Alexdelia/keyboard/keyboard/icarus/pcb/right/right.kicad_pcb

## KiCad design keyboard/icarus/pcb/right/right.kicad_pcb (2026-11-09)

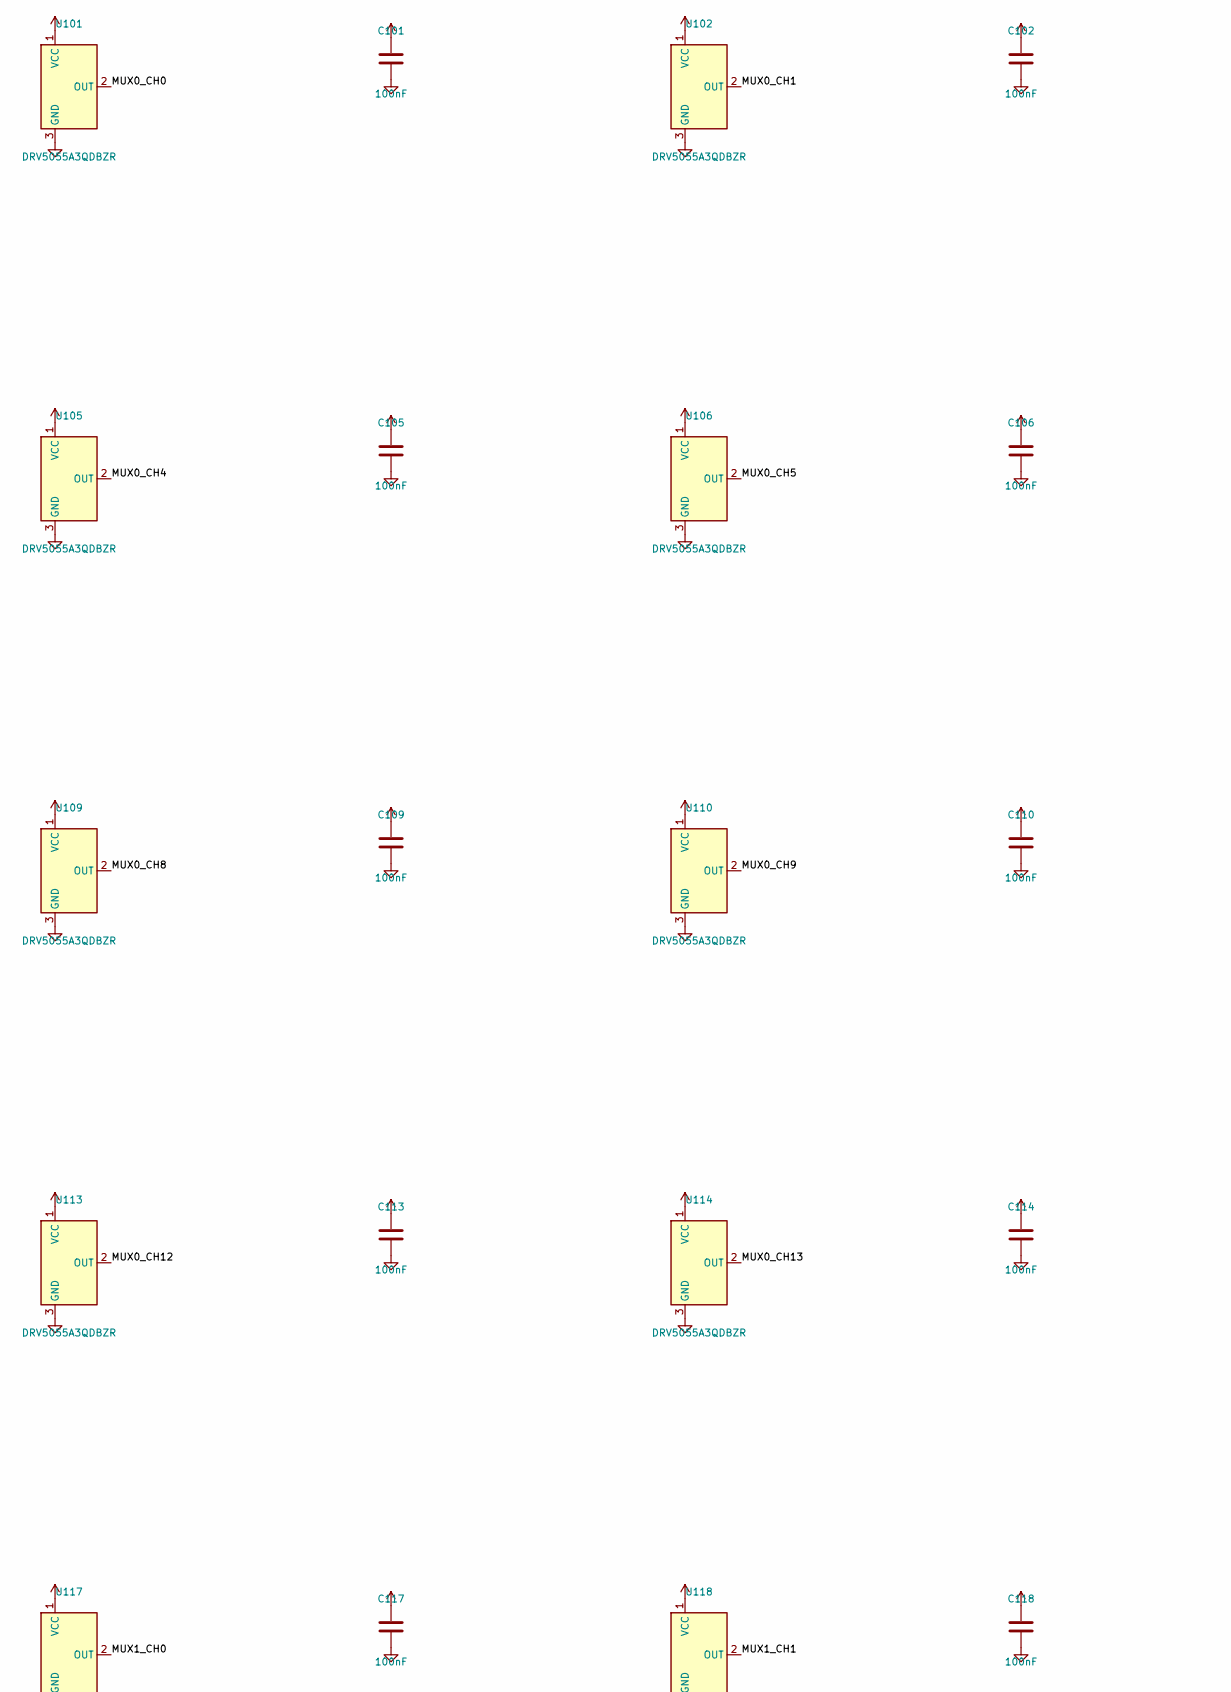
[picture p1: schematic right.kicad_sch, part in row 1, column 1]

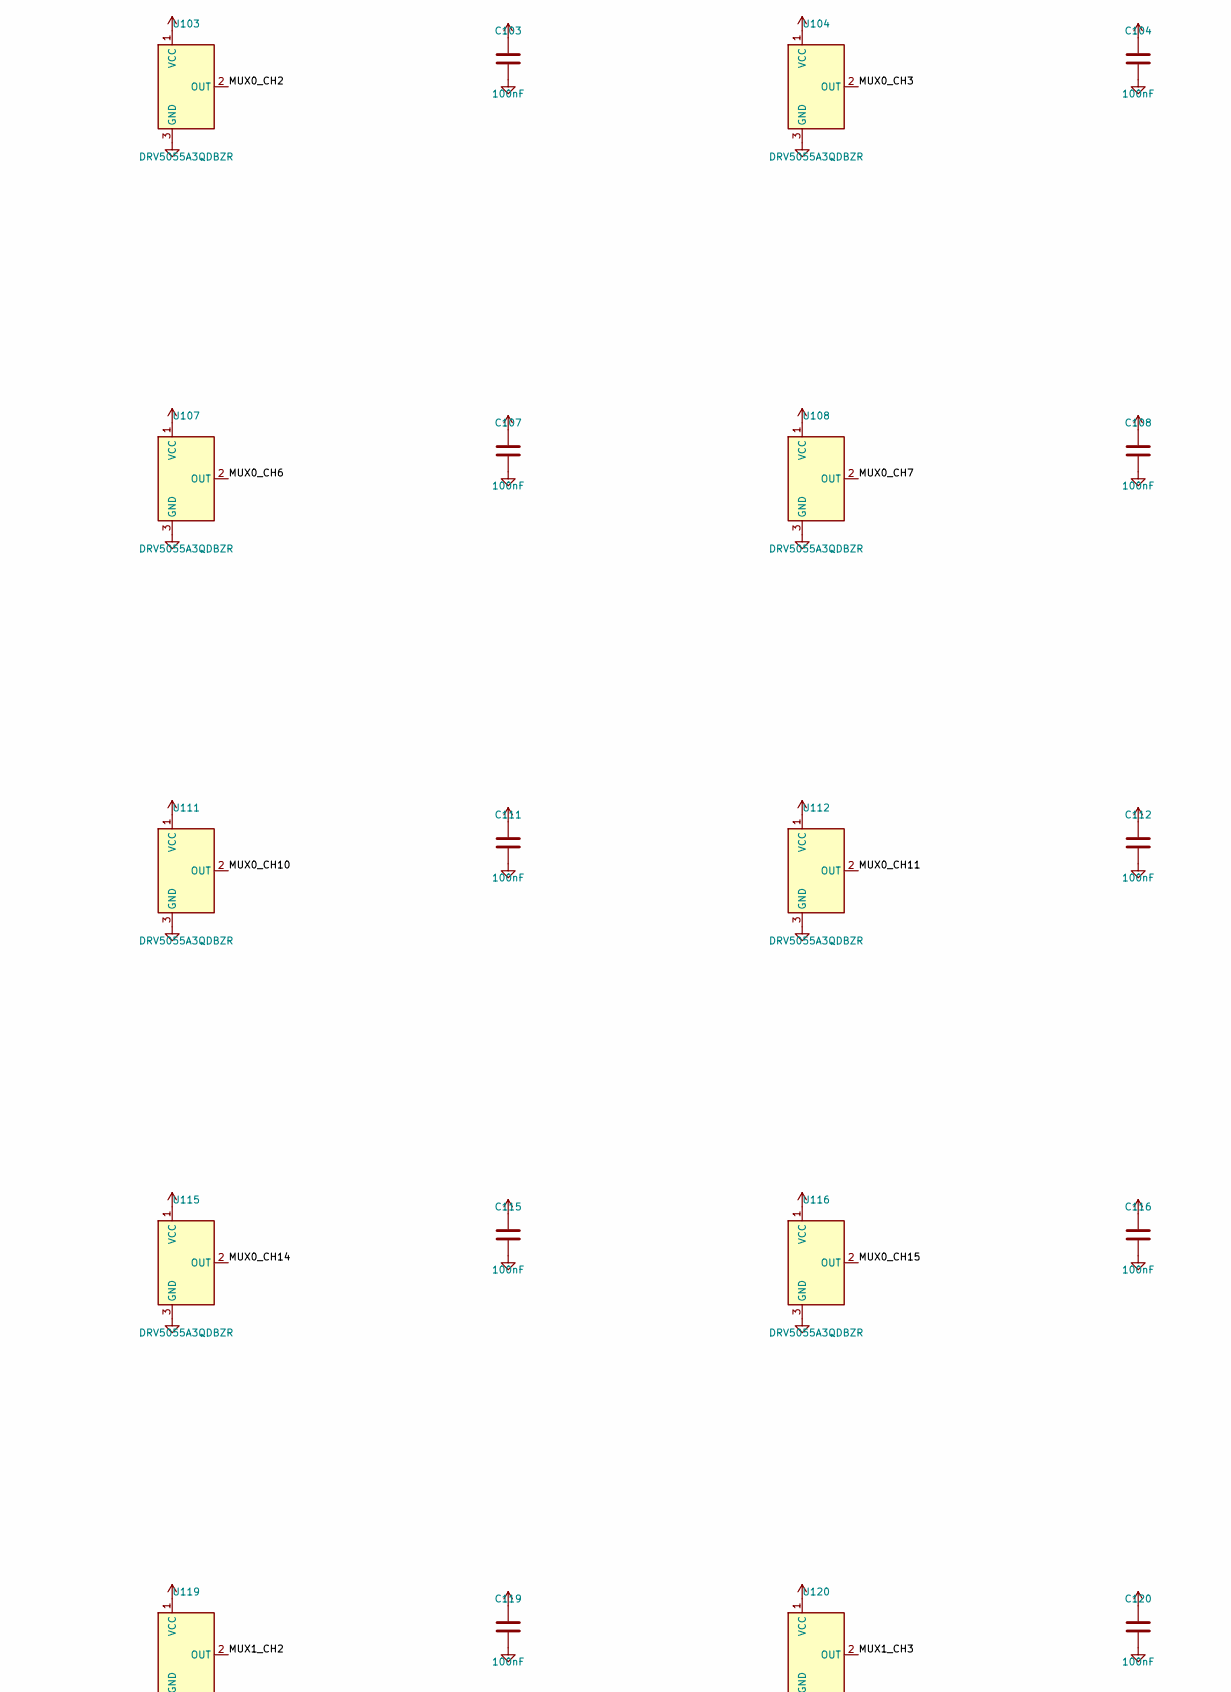
[picture p2: schematic right.kicad_sch, part in row 1, column 2]

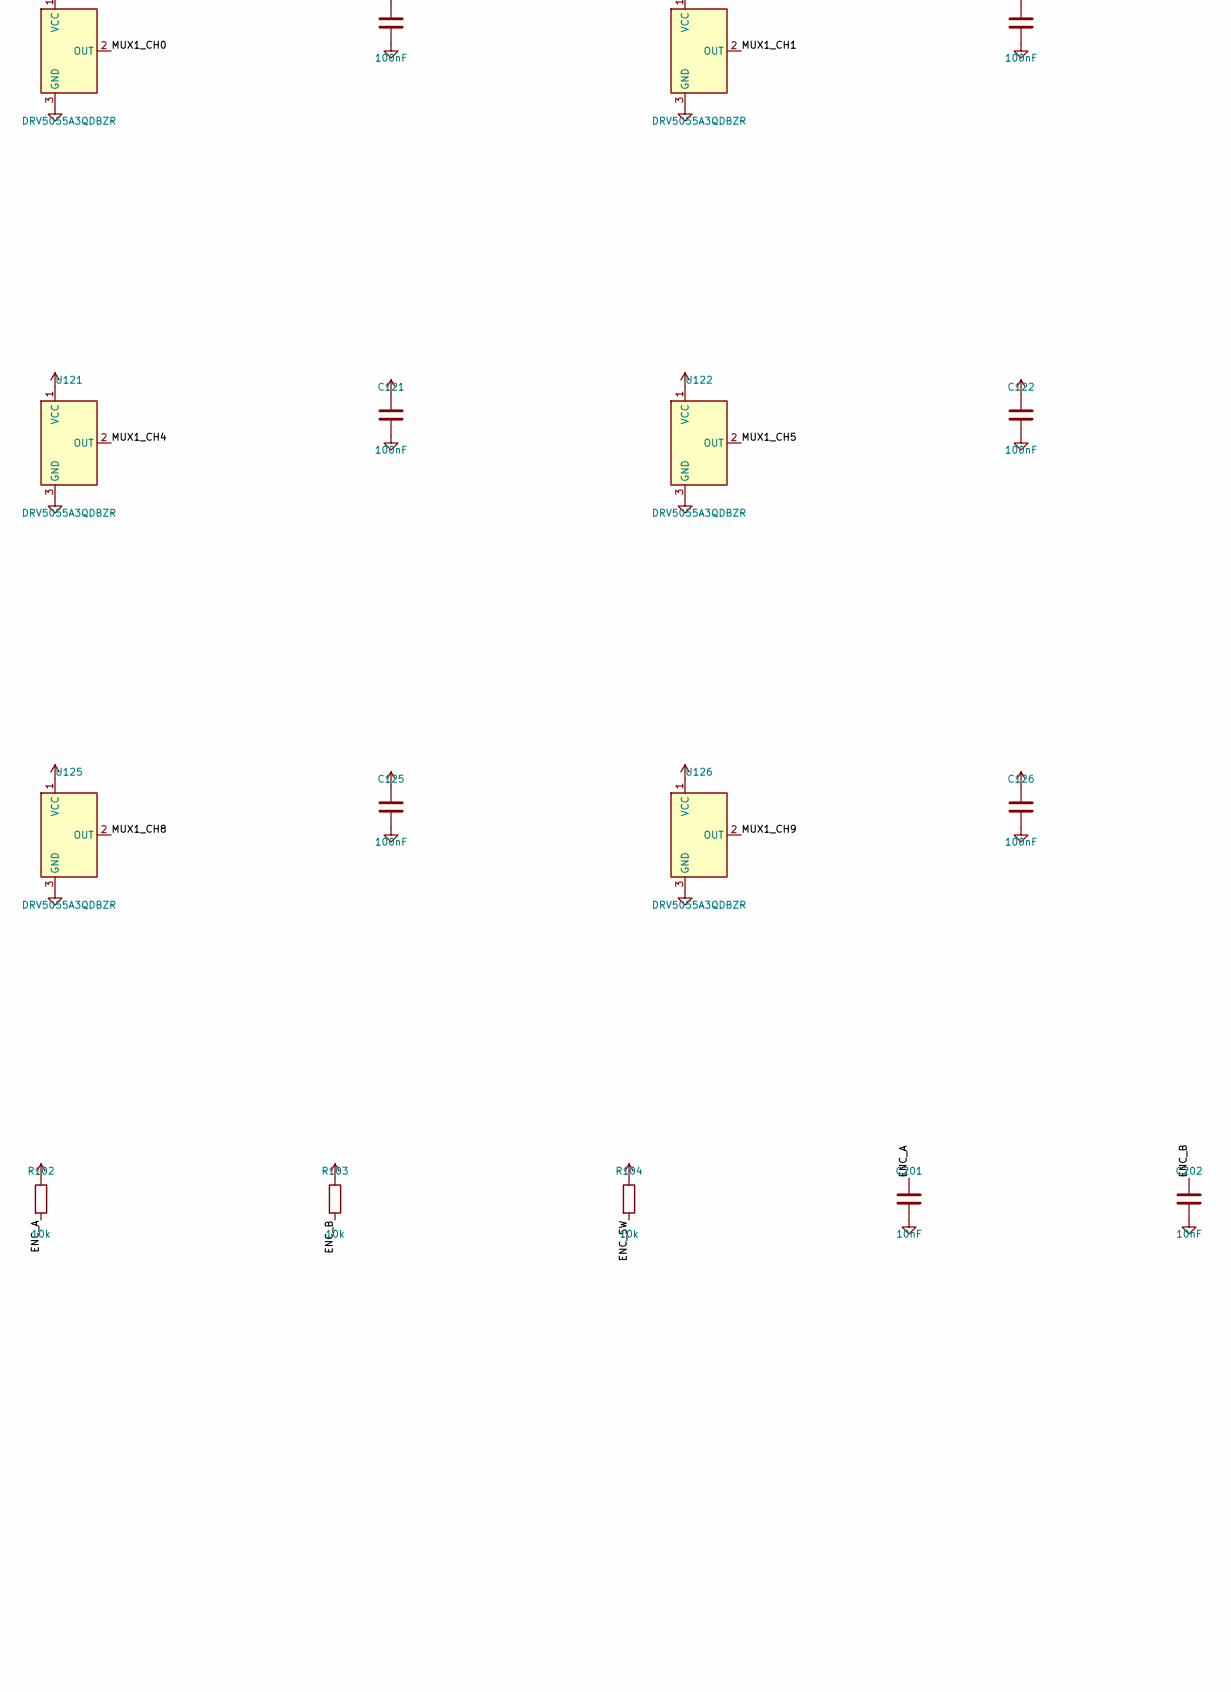
[picture p3: schematic right.kicad_sch, part in row 2, column 1]

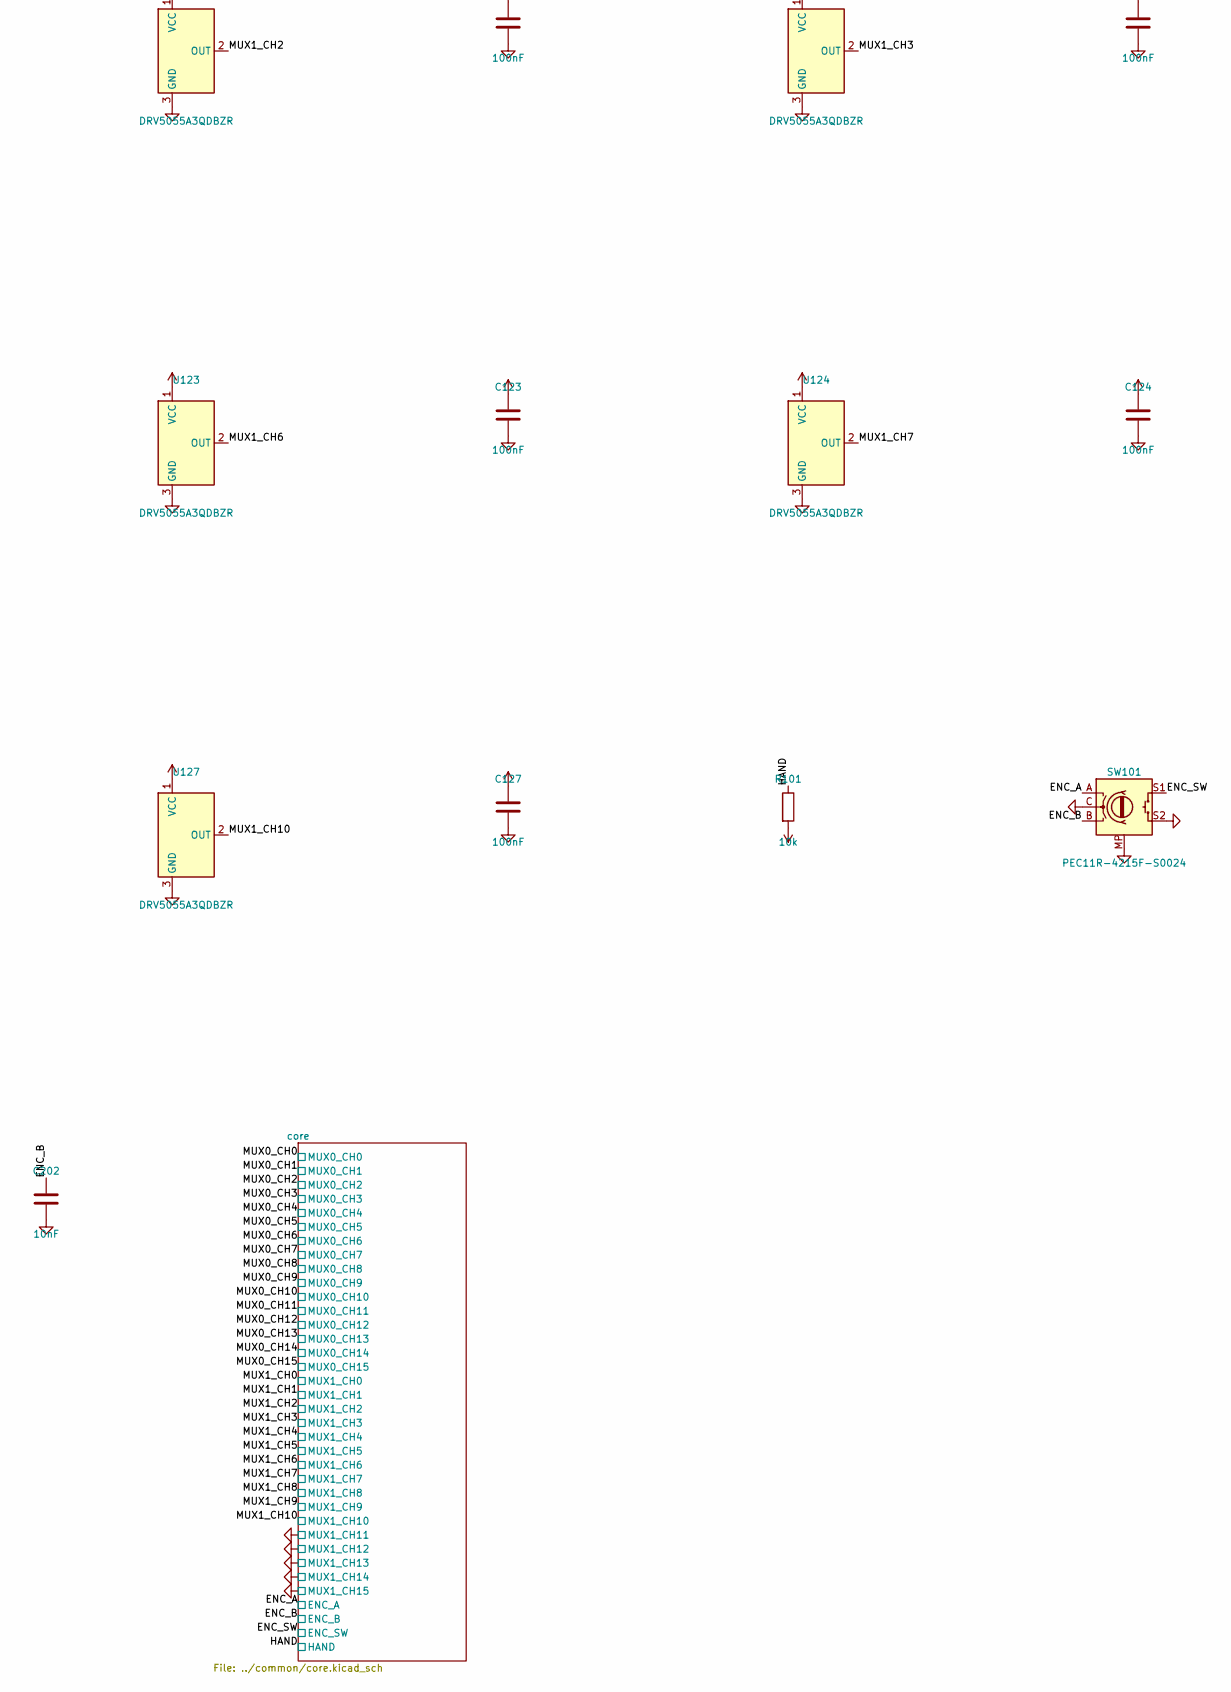
[picture p4: schematic right.kicad_sch, part in row 2, column 2]

Parts:
C101, C102, C103, C104, C105, C106, C107, C108, C109, C110, C111, C112, C113, C114, C115, C116, C117, C118, C119, C120, C121, C122, C123, C124, C125, C126, C127: 100nF; C_0402_1005Metric; MPN CL05B104KO5NNNC; LCSC C1525
C201, C202: 10nF; C_0402_1005Metric; MPN CL05B103KB5NNNC; LCSC C15195
R101, R102, R103, R104: 10k; R_0402_1005Metric; MPN 0402WGF1002TCE; LCSC C25744
SW101: PEC11R-4215F-S0024; RotaryEncoder_Bourns_PEC11R-4xxxF-Sxxxx_Vertical; MPN PEC11R-4215F-S0024; LCSC C143790
U101, U102, U103, U104, U105, U106, U107, U108, U109, U110, U111, U112, U113, U114, U115, U116, U117, U118, U119, U120, U121, U122, U123, U124, U125, U126, U127: DRV5055A3QDBZR; SOT-23; MPN DRV5055A3QDBZR; LCSC C266128

Connections:
+3V3: C101.1, C102.1, C103.1, C104.1, C105.1, C106.1, C107.1, C108.1, C109.1, C110.1, C111.1, C112.1, C113.1, C114.1, C115.1, C116.1, C117.1, C118.1, C119.1, C120.1, C121.1, C122.1, C123.1, C124.1, C125.1, C126.1, C127.1, R101.2, R102.1, R103.1, R104.1, U101.1 (VCC), U102.1 (VCC), U103.1 (VCC), U104.1 (VCC), U105.1 (VCC), U106.1 (VCC), U107.1 (VCC), U108.1 (VCC), U109.1 (VCC), U110.1 (VCC), U111.1 (VCC), U112.1 (VCC), U113.1 (VCC), U114.1 (VCC), U115.1 (VCC), U116.1 (VCC), U117.1 (VCC), U118.1 (VCC), U119.1 (VCC), U120.1 (VCC), U121.1 (VCC), U122.1 (VCC), U123.1 (VCC), U124.1 (VCC), U125.1 (VCC), U126.1 (VCC), U127.1 (VCC); also elsewhere on the board
/ENC_A: C201.1, R102.2, SW101.A; also elsewhere on the board
/ENC_B: C202.1, R103.2, SW101.B; also elsewhere on the board
/ENC_SW: R104.2, SW101.S1; also elsewhere on the board
/HAND: R101.1; also elsewhere on the board
/MUX0_CH0: U101.2 (OUT); also elsewhere on the board
/MUX0_CH1: U102.2 (OUT); also elsewhere on the board
/MUX0_CH2: U103.2 (OUT); also elsewhere on the board
/MUX0_CH3: U104.2 (OUT); also elsewhere on the board
/MUX0_CH4: U105.2 (OUT); also elsewhere on the board
/MUX0_CH5: U106.2 (OUT); also elsewhere on the board
/MUX0_CH6: U107.2 (OUT); also elsewhere on the board
/MUX0_CH7: U108.2 (OUT); also elsewhere on the board
/MUX0_CH8: U109.2 (OUT); also elsewhere on the board
/MUX0_CH9: U110.2 (OUT); also elsewhere on the board
/MUX0_CH10: U111.2 (OUT); also elsewhere on the board
/MUX0_CH11: U112.2 (OUT); also elsewhere on the board
/MUX0_CH12: U113.2 (OUT); also elsewhere on the board
/MUX0_CH13: U114.2 (OUT); also elsewhere on the board
/MUX0_CH14: U115.2 (OUT); also elsewhere on the board
/MUX0_CH15: U116.2 (OUT); also elsewhere on the board
/MUX1_CH0: U117.2 (OUT); also elsewhere on the board
/MUX1_CH1: U118.2 (OUT); also elsewhere on the board
/MUX1_CH2: U119.2 (OUT); also elsewhere on the board
/MUX1_CH3: U120.2 (OUT); also elsewhere on the board
/MUX1_CH4: U121.2 (OUT); also elsewhere on the board
/MUX1_CH5: U122.2 (OUT); also elsewhere on the board
/MUX1_CH6: U123.2 (OUT); also elsewhere on the board
/MUX1_CH7: U124.2 (OUT); also elsewhere on the board
/MUX1_CH8: U125.2 (OUT); also elsewhere on the board
/MUX1_CH9: U126.2 (OUT); also elsewhere on the board
/MUX1_CH10: U127.2 (OUT); also elsewhere on the board
GND: C101.2, C102.2, C103.2, C104.2, C105.2, C106.2, C107.2, C108.2, C109.2, C110.2, C111.2, C112.2, C113.2, C114.2, C115.2, C116.2, C117.2, C118.2, C119.2, C120.2, C121.2, C122.2, C123.2, C124.2, C125.2, C126.2, C127.2, C201.2, C202.2, SW101.C, SW101.MP, SW101.S2, U101.3 (GND), U102.3 (GND), U103.3 (GND), U104.3 (GND), U105.3 (GND), U106.3 (GND), U107.3 (GND), U108.3 (GND), U109.3 (GND), U110.3 (GND), U111.3 (GND), U112.3 (GND), U113.3 (GND), U114.3 (GND), U115.3 (GND), U116.3 (GND), U117.3 (GND), U118.3 (GND), U119.3 (GND), U120.3 (GND), U121.3 (GND), U122.3 (GND), U123.3 (GND), U124.3 (GND), U125.3 (GND), U126.3 (GND), U127.3 (GND); also elsewhere on the board

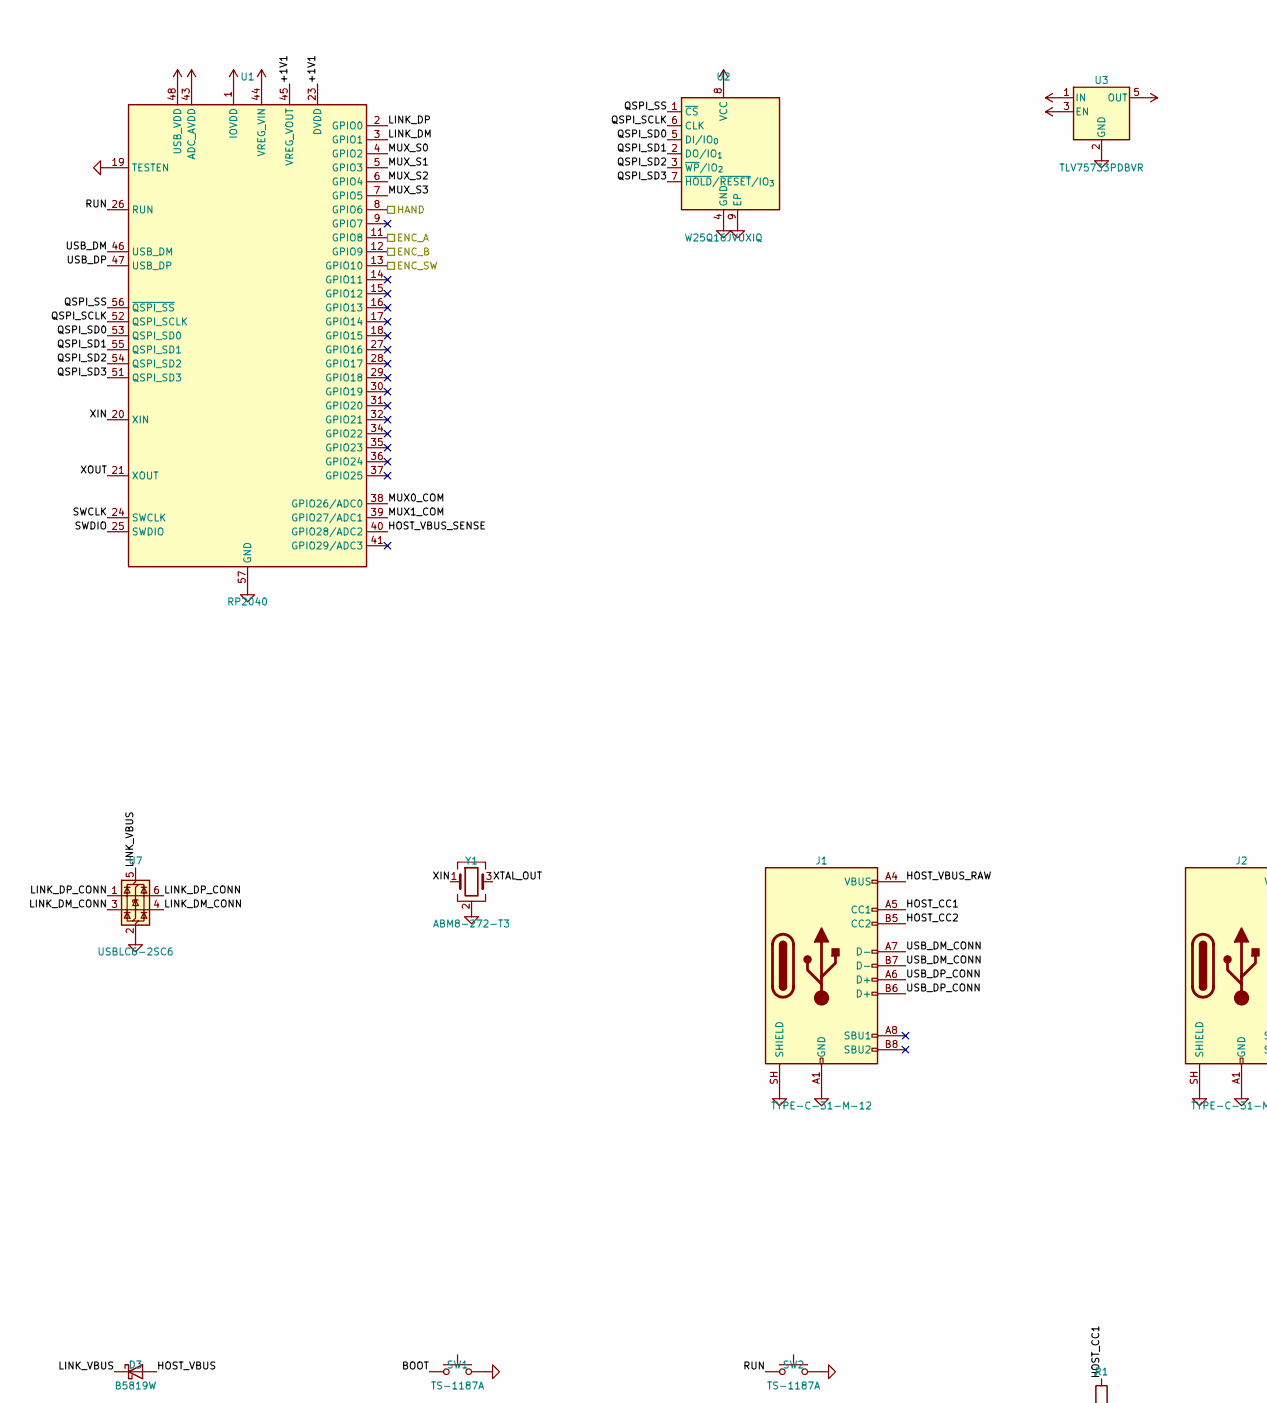
[picture p5: schematic core.kicad_sch, part in row 1, column 1]

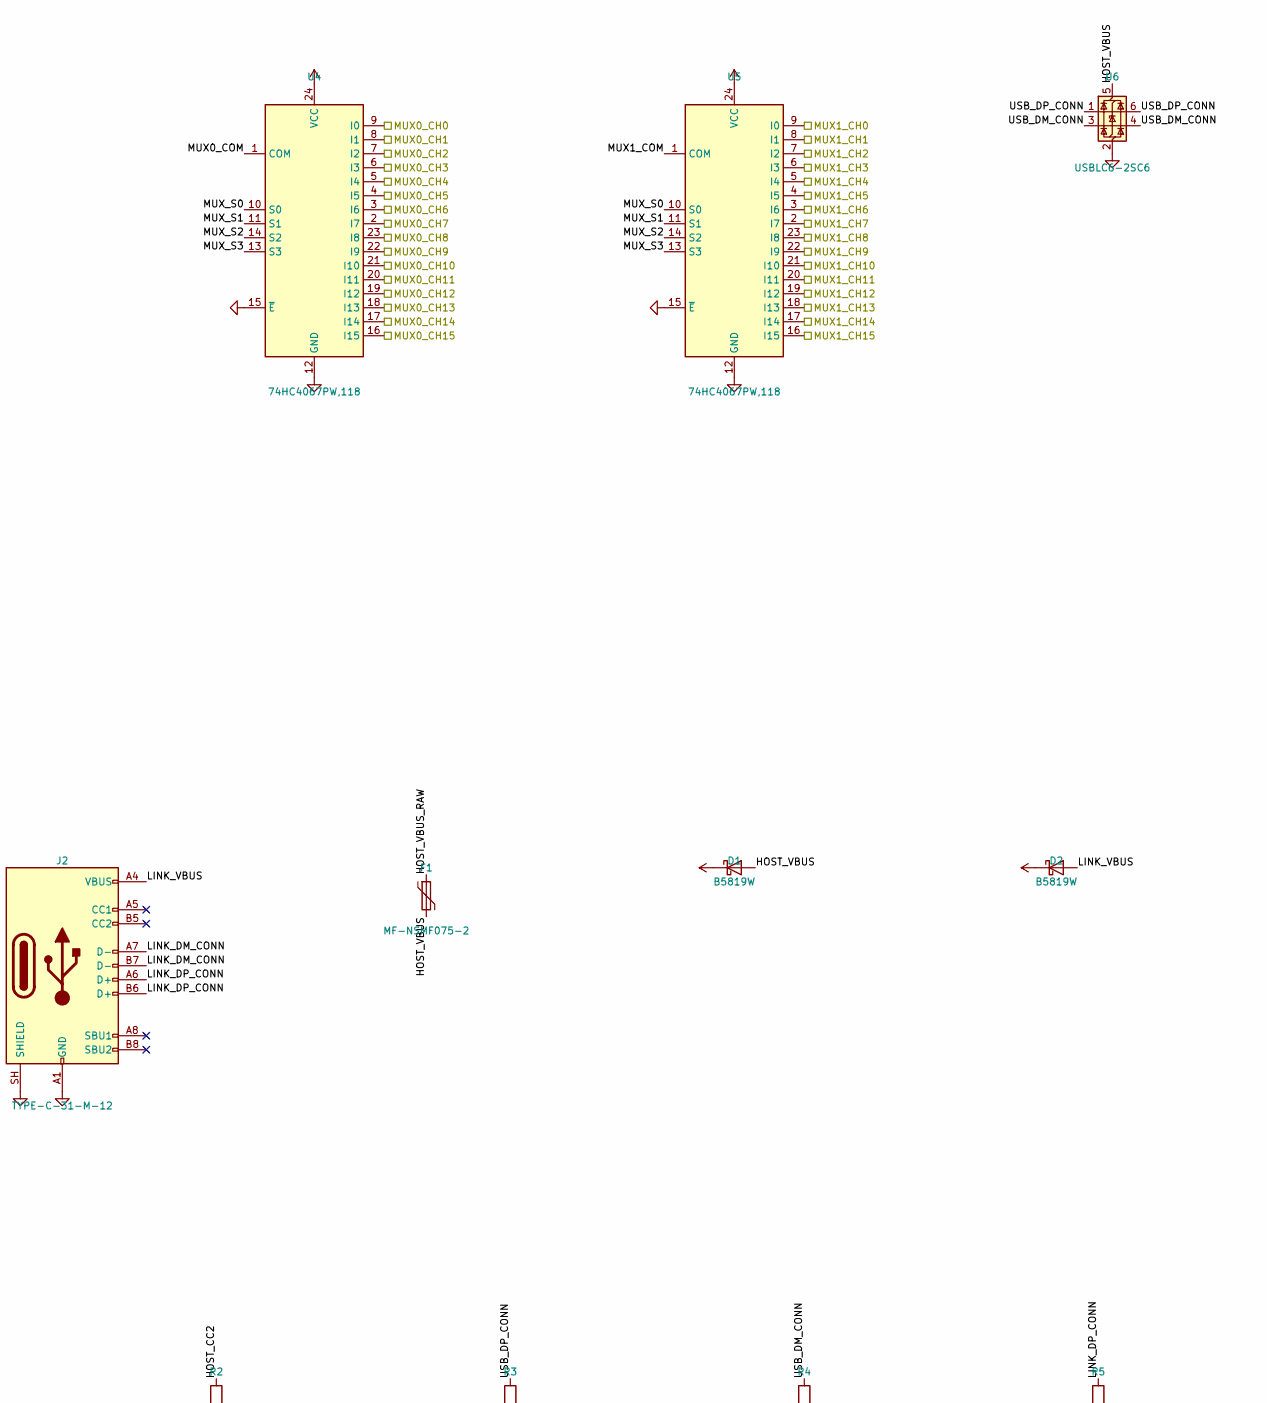
[picture p6: schematic core.kicad_sch, part in row 1, column 2]

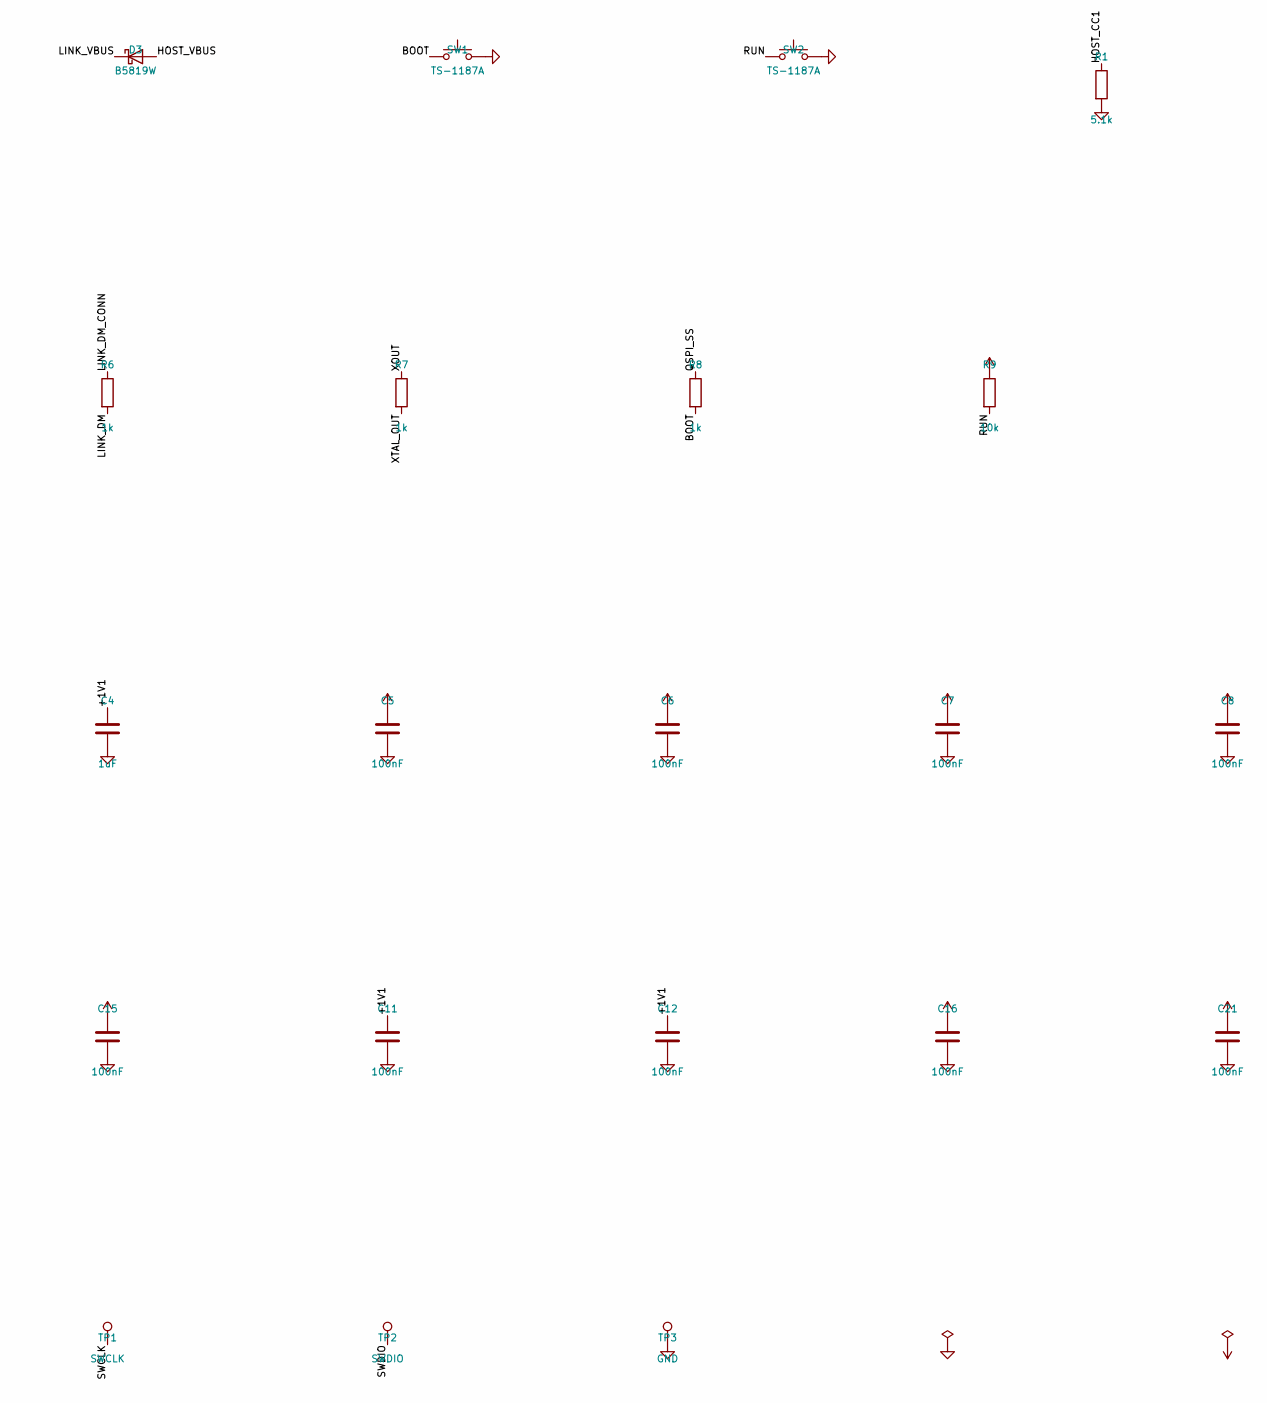
[picture p7: schematic core.kicad_sch, part in row 2, column 1]

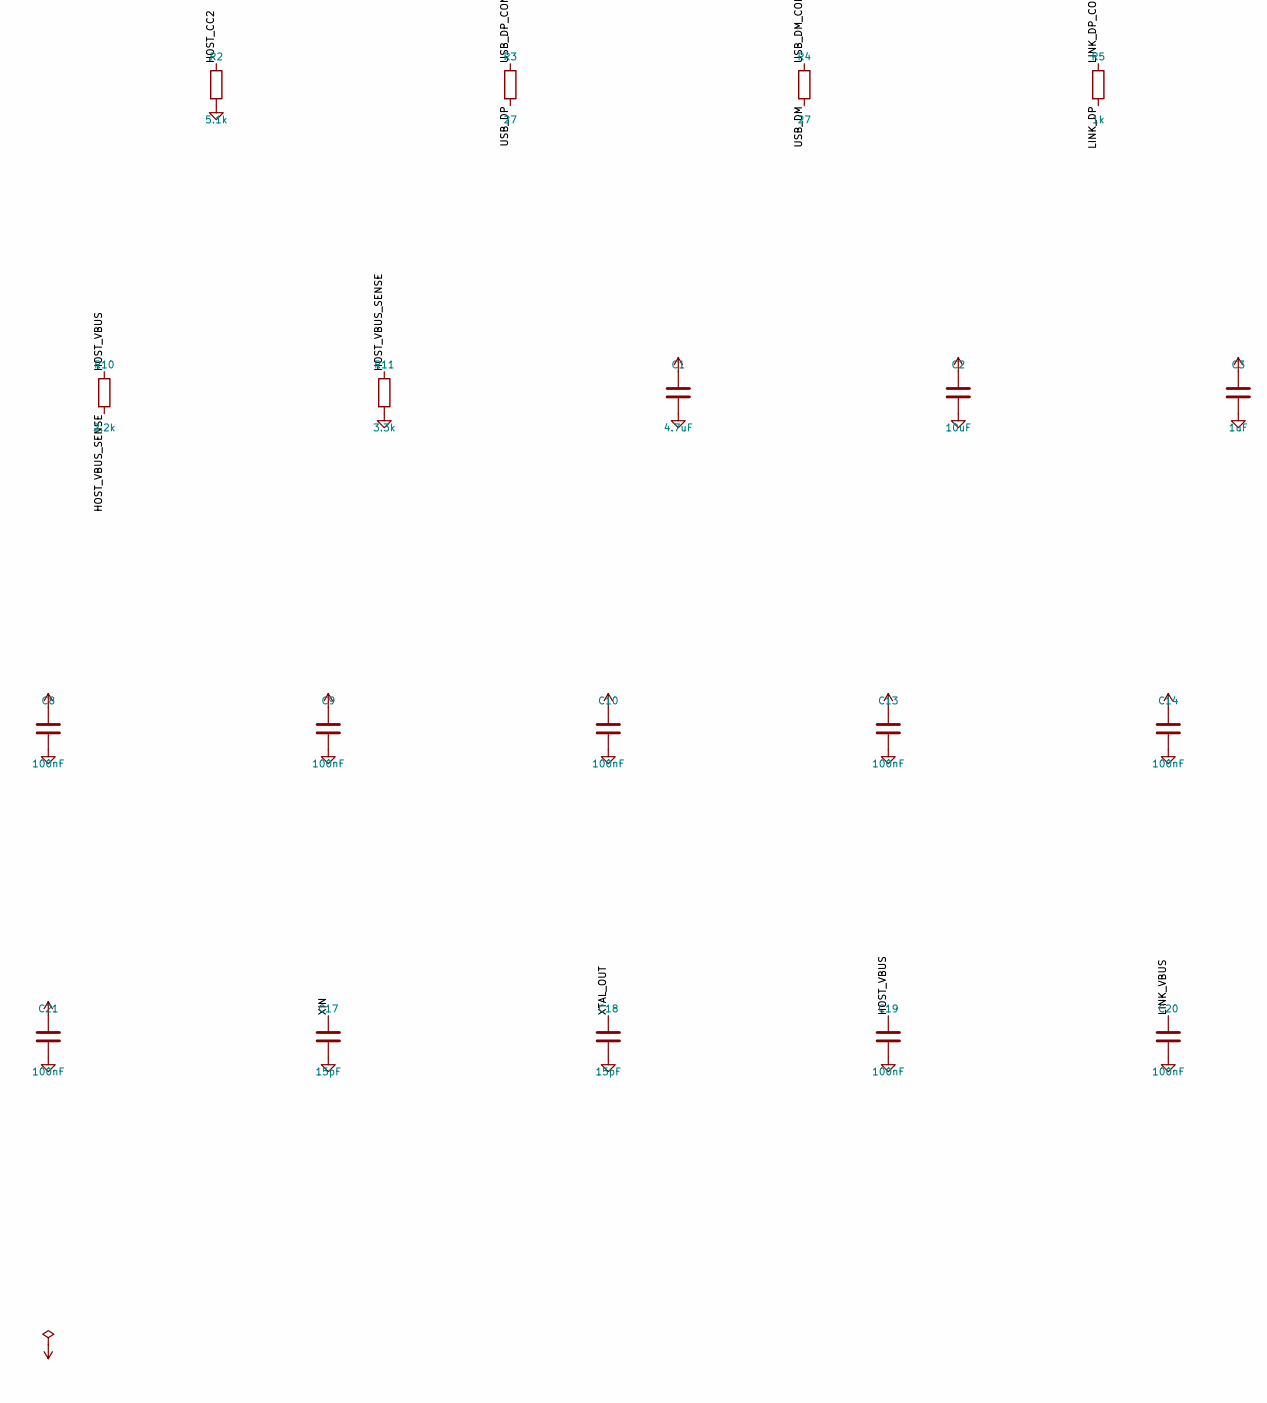
[picture p8: schematic core.kicad_sch, part in row 2, column 2]

Parts:
C1: 4.7uF; C_0402_1005Metric; MPN CL05A475MP5NRNC; LCSC C23733
C2: 10uF; C_0402_1005Metric; MPN CL05A106MQ5NUNC; LCSC C15525
C3, C4: 1uF; C_0402_1005Metric; MPN CL05A105KA5NQNC; LCSC C52923
C5, C6, C7, C8, C9, C10, C11, C12, C13, C14, C15, C16, C19, C20, C21: 100nF; C_0402_1005Metric; MPN CL05B104KO5NNNC; LCSC C1525
C17, C18: 15pF; C_0402_1005Metric; MPN 0402CG150J500NT; LCSC C1548
D1, D2, D3: B5819W; D_SOD-123; MPN B5819W SL; LCSC C8598
F1: MF-NSMF075-2; Fuse_1206_3216Metric; MPN MF-NSMF075-2; LCSC C89653
J1, J2: TYPE-C-31-M-12; USB_C_Receptacle_HRO_TYPE-C-31-M-12; MPN TYPE-C-31-M-12; LCSC C165948
R1, R2: 5.1k; R_0402_1005Metric; MPN 0402WGF5101TCE; LCSC C25905
R3, R4: 27; R_0402_1005Metric; MPN 0402WGF270JTCE; LCSC C25100
R5, R6, R7, R8: 1k; R_0402_1005Metric; MPN 0402WGF1001TCE; LCSC C11702
R9: 10k; R_0402_1005Metric; MPN 0402WGF1002TCE; LCSC C25744
R10: 2.2k; R_0402_1005Metric; MPN 0402WGF2201TCE; LCSC C25879
R11: 3.3k; R_0402_1005Metric; MPN 0402WGF3301TCE; LCSC C25890
SW1, SW2: TS-1187A; SW_Push_1P1T_XKB_TS-1187A; MPN TS-1187A-B-A-B; LCSC C318884
TP1: SWCLK; TestPoint_Pad_D1.0mm
TP2: SWDIO; TestPoint_Pad_D1.0mm
TP3: GND; TestPoint_Pad_D1.0mm
U1: RP2040; QFN-56-1EP_7x7mm_P0.4mm_EP3.2x3.2mm; MPN RP2040; LCSC C2040
U2: W25Q16JVUXIQ; Winbond_USON-8-1EP_3x2mm_P0.5mm_EP0.2x1.6mm; MPN W25Q16JVUXIQ; LCSC C2843335
U3: TLV75733PDBVR; SOT-23-5; MPN TLV75733PDBVR; LCSC C485517
U4, U5: 74HC4067PW,118; TSSOP-24_4.4x7.8mm_P0.65mm; MPN 74HC4067PW,118; LCSC C179326
U6, U7: USBLC6-2SC6; SOT-23-6; MPN USBLC6-2SC6; LCSC C7519
Y1: ABM8-272-T3; Crystal_SMD_3225-4Pin_3.2x2.5mm; MPN ABM8-272-T3; LCSC C20625731

Connections:
+3V3: C2.1, C3.1, C5.1, C6.1, C7.1, C8.1, C9.1, C10.1, C13.1, C14.1, C15.1, C16.1, C21.1, R9.1, U1.1 (IOVDD), U1.10 (IOVDD), U1.22 (IOVDD), U1.33 (IOVDD), U1.42 (IOVDD), U1.43 (ADC_AVDD), U1.44 (VREG_VIN), U1.48 (USB_VDD), U1.49 (IOVDD), U2.8 (VCC), U3.5 (OUT), U4.24 (VCC), U5.24 (VCC); also elsewhere on the board
+5V: C1.1, D1.1 (K), D2.1 (K), U3.1 (IN), U3.3 (EN)
/ENC_A: U1.11 (GPIO8); also elsewhere on the board
/ENC_B: U1.12 (GPIO9); also elsewhere on the board
/ENC_SW: U1.13 (GPIO10); also elsewhere on the board
/HAND: U1.8 (GPIO6); also elsewhere on the board
/MUX0_CH0: U4.9 (I0); also elsewhere on the board
/MUX0_CH1: U4.8 (I1); also elsewhere on the board
/MUX0_CH2: U4.7 (I2); also elsewhere on the board
/MUX0_CH3: U4.6 (I3); also elsewhere on the board
/MUX0_CH4: U4.5 (I4); also elsewhere on the board
/MUX0_CH5: U4.4 (I5); also elsewhere on the board
/MUX0_CH6: U4.3 (I6); also elsewhere on the board
/MUX0_CH7: U4.2 (I7); also elsewhere on the board
/MUX0_CH8: U4.23 (I8); also elsewhere on the board
/MUX0_CH9: U4.22 (I9); also elsewhere on the board
/MUX0_CH10: U4.21 (I10); also elsewhere on the board
/MUX0_CH11: U4.20 (I11); also elsewhere on the board
/MUX0_CH12: U4.19 (I12); also elsewhere on the board
/MUX0_CH13: U4.18 (I13); also elsewhere on the board
/MUX0_CH14: U4.17 (I14); also elsewhere on the board
/MUX0_CH15: U4.16 (I15); also elsewhere on the board
/MUX1_CH0: U5.9 (I0); also elsewhere on the board
/MUX1_CH1: U5.8 (I1); also elsewhere on the board
/MUX1_CH2: U5.7 (I2); also elsewhere on the board
/MUX1_CH3: U5.6 (I3); also elsewhere on the board
/MUX1_CH4: U5.5 (I4); also elsewhere on the board
/MUX1_CH5: U5.4 (I5); also elsewhere on the board
/MUX1_CH6: U5.3 (I6); also elsewhere on the board
/MUX1_CH7: U5.2 (I7); also elsewhere on the board
/MUX1_CH8: U5.23 (I8); also elsewhere on the board
/MUX1_CH9: U5.22 (I9); also elsewhere on the board
/MUX1_CH10: U5.21 (I10); also elsewhere on the board
/core/+1V1: C4.1, C11.1, C12.1, U1.23 (DVDD), U1.45 (VREG_VOUT), U1.50 (DVDD)
/core/BOOT: R8.2, SW1.1
/core/HOST_CC1: J1.A5 (CC1), R1.1
/core/HOST_CC2: J1.B5 (CC2), R2.1
/core/HOST_VBUS: C19.1, D1.2 (A), D3.2 (A), F1.2, R10.1, U6.5 (VBUS)
/core/HOST_VBUS_RAW: F1.1, J1.A4 (VBUS), J1.A9 (VBUS), J1.B4 (VBUS), J1.B9 (VBUS)
/core/HOST_VBUS_SENSE: R10.2, R11.1, U1.40 (GPIO28/ADC2)
/core/LINK_DM: R6.2, U1.3 (GPIO1)
/core/LINK_DM_CONN: J2.A7 (D-), J2.B7 (D-), R6.1, U7.3 (I/O2), U7.4 (I/O2)
/core/LINK_DP: R5.2, U1.2 (GPIO0)
/core/LINK_DP_CONN: J2.A6 (D+), J2.B6 (D+), R5.1, U7.1 (I/O1), U7.6 (I/O1)
/core/LINK_VBUS: C20.1, D2.2 (A), D3.1 (K), J2.A4 (VBUS), J2.A9 (VBUS), J2.B4 (VBUS), J2.B9 (VBUS), U7.5 (VBUS)
/core/MUX0_COM: U1.38 (GPIO26/ADC0), U4.1 (COM)
/core/MUX1_COM: U1.39 (GPIO27/ADC1), U5.1 (COM)
/core/MUX_S0: U1.4 (GPIO2), U4.10 (S0), U5.10 (S0)
/core/MUX_S1: U1.5 (GPIO3), U4.11 (S1), U5.11 (S1)
/core/MUX_S2: U1.6 (GPIO4), U4.14 (S2), U5.14 (S2)
/core/MUX_S3: U1.7 (GPIO5), U4.13 (S3), U5.13 (S3)
/core/QSPI_SCLK: U1.52 (QSPI_SCLK), U2.6 (CLK)
/core/QSPI_SD0: U1.53 (QSPI_SD0), U2.5 (DI/IO_{0})
/core/QSPI_SD1: U1.55 (QSPI_SD1), U2.2 (DO/IO_{1})
/core/QSPI_SD2: U1.54 (QSPI_SD2), U2.3 (~WP/IO_{2})
/core/QSPI_SD3: U1.51 (QSPI_SD3), U2.7 (~HOLD/~RESET/IO_{3})
/core/QSPI_SS: R8.1, U1.56 (~QSPI_SS), U2.1 (~CS)
/core/RUN: R9.2, SW2.1, U1.26 (RUN)
/core/SWCLK: TP1.1, U1.24 (SWCLK)
/core/SWDIO: TP2.1, U1.25 (SWDIO)
/core/USB_DM: R4.2, U1.46 (USB_DM)
/core/USB_DM_CONN: J1.A7 (D-), J1.B7 (D-), R4.1, U6.3 (I/O2), U6.4 (I/O2)
/core/USB_DP: R3.2, U1.47 (USB_DP)
/core/USB_DP_CONN: J1.A6 (D+), J1.B6 (D+), R3.1, U6.1 (I/O1), U6.6 (I/O1)
/core/XIN: C17.1, U1.20 (XIN), Y1.1
/core/XOUT: R7.1, U1.21 (XOUT)
/core/XTAL_OUT: C18.1, R7.2, Y1.3
GND: C1.2, C2.2, C3.2, C4.2, C5.2, C6.2, C7.2, C8.2, C9.2, C10.2, C11.2, C12.2, C13.2, C14.2, C15.2, C16.2, C17.2, C18.2, C19.2, C20.2, C21.2, J1.A1 (GND), J1.A12 (GND), J1.B1 (GND), J1.B12 (GND), J1.SH (SHIELD), J2.A1 (GND), J2.A12 (GND), J2.B1 (GND), J2.B12 (GND), J2.SH (SHIELD), R1.2, R2.2, R11.2, SW1.2, SW2.2, TP3.1, U1.19 (TESTEN), U1.57 (GND), U2.4 (GND), U2.9 (EP), U3.2 (GND), U4.12 (GND), U4.15 (~E), U5.12 (GND), U5.15 (~E), U5.16 (I15), U5.17 (I14), U5.18 (I13), U5.19 (I12), U5.20 (I11), U6.2 (GND), U7.2 (GND), Y1.2 (G), Y1.4 (G); also elsewhere on the board

Board: 2 copper layers, 145 parts (111 on the bottom side), 68 nets, no tracks yet.

Other parts of the board:
K1: top-pinkyOuter; Gateron_KS33_Magnetic_Jade
K2: home-pinkyOuter; Gateron_KS33_Magnetic_Jade
K3: bottom-pinkyOuter; Gateron_KS33_Magnetic_Jade
K4: number-pinky; Gateron_KS33_Magnetic_Jade
K5: top-pinky; Gateron_KS33_Magnetic_Jade
K6: home-pinky; Gateron_KS33_Magnetic_Jade
K7: bottom-pinky; Gateron_KS33_Magnetic_Jade
K8: number-ring; Gateron_KS33_Magnetic_Jade
K9: top-ring; Gateron_KS33_Magnetic_Jade
K10: home-ring; Gateron_KS33_Magnetic_Jade
K11: bottom-ring; Gateron_KS33_Magnetic_Jade
K12: number-middle; Gateron_KS33_Magnetic_Jade
K13: top-middle; Gateron_KS33_Magnetic_Jade
K14: home-middle; Gateron_KS33_Magnetic_Jade
K15: bottom-middle; Gateron_KS33_Magnetic_Jade
K16: number-index; Gateron_KS33_Magnetic_Jade
K17: top-index; Gateron_KS33_Magnetic_Jade
K18: home-index; Gateron_KS33_Magnetic_Jade
K19: bottom-index; Gateron_KS33_Magnetic_Jade
K20: number-indexInner; Gateron_KS33_Magnetic_Jade
K21: top-indexInner; Gateron_KS33_Magnetic_Jade
K22: home-indexInner; Gateron_KS33_Magnetic_Jade
K23: bottom-indexInner; Gateron_KS33_Magnetic_Jade
K24: thumb0; Gateron_KS33_Magnetic_Jade
K25: thumb1; Gateron_KS33_Magnetic_Jade
K26: thumb2; Gateron_KS33_Magnetic_Jade
K27: thumb3; Gateron_KS33_Magnetic_Jade
MH1, MH2, MH3, MH4, MH5, MH6: M2; MountingHole_2.2mm_M2
