Alexdelia/keyboard/tool/test/test_plate.py

import xml.etree.ElementTree as ET
from pathlib import Path

import pytest
from kb import plate
from kb.layout import Board, KeyPosition, Side, half_positions, load_board
from kb.outline import (
	ENCODER_FOOTPRINT_FILE,
	ENCODER_SHAFT_LOCAL_MM,
	HOLE_DIAMETER_MM,
	Point,
	board_outline,
	encoder_opening_local,
)
from kb.parts import load_parts
from kb.placement import board_holes, button_holes
from kb.plate import (
	BOTTOM_STANDOFF_HEIGHT_MM,
	STANDOFF_HEIGHT_MM,
	write_plate_svg,
)
from kb.sexpr import parse as parse_sexpr

BOARD_DIR = Path(__file__).parents[2] / "keyboard" / "icarus"
SVG = "{http://www.w3.org/2000/svg}"
SIDES: tuple[Side, ...] = ("left", "right")
Half = tuple[list[KeyPosition], list[Point], list[Point]]


@pytest.fixture(scope="module")
def board() -> Board:
	return load_board(BOARD_DIR)


@pytest.fixture(scope="module")
def built(board: Board) -> dict[Side, Half]:
	holes = board_holes(BOARD_DIR)
	return {
		side: (half_positions(board, side), board_outline(board, side), holes[side])
		for side in SIDES
	}


def build(built: dict[Side, Half], side: Side) -> Half:
	return built[side]


def parse(path: Path) -> ET.Element:
	return ET.parse(path).getroot()


def attribute(element: ET.Element, name: str) -> str:
	value = element.get(name)
	assert value is not None
	return value


def number(element: ET.Element, name: str) -> float:
	return float(attribute(element, name))


@pytest.mark.parametrize("side", SIDES)
def test_plate_has_cutout_per_key(
	built: dict[Side, Half], side: Side, tmp_path: Path
) -> None:
	positions, outline, holes = build(built, side)
	path = tmp_path / "plate.svg"
	write_plate_svg(path, positions, outline, holes, "plate")
	rects = parse(path).findall(f".//{SVG}rect")
	assert len(rects) == 28
	squares = [r for r in rects if number(r, "width") == pytest.approx(14.0)]
	assert len(squares) == 27
	for rect in squares:
		assert number(rect, "height") == pytest.approx(14.0, abs=0.001)


def encoder_pad_extents_from_shaft() -> list[tuple[float, float, float, float]]:
	tree = parse_sexpr(ENCODER_FOOTPRINT_FILE.read_text())
	shaft_x, shaft_y = ENCODER_SHAFT_LOCAL_MM
	extents = []
	for node in tree:
		if isinstance(node, list) and node and node[0] == "pad":
			at = next(c for c in node if isinstance(c, list) and c[0] == "at")
			size = next(c for c in node if isinstance(c, list) and c[0] == "size")
			x, y = float(at[1]) - shaft_x, float(at[2]) - shaft_y
			w, h = float(size[1]) / 2, float(size[2]) / 2
			extents.append((x - w, y - h, x + w, y + h))
	return extents


@pytest.mark.parametrize("side", SIDES)
def test_knob_opening_is_encoder_courtyard_around_shaft(
	built: dict[Side, Half], side: Side
) -> None:
	positions, _, _ = build(built, side)
	(knob,) = [k for k in positions if k.kind == "knob"]
	(opening,) = [
		r
		for r in parse(BOARD_DIR / "plate" / f"{side}-plate.svg").findall(
			f".//{SVG}rect"
		)
		if number(r, "width") != pytest.approx(14.0)
	]
	assert number(opening, "width") == pytest.approx(17.0)
	assert number(opening, "height") == pytest.approx(16.3)
	x0, y0, x1, y1 = encoder_opening_local()
	assert number(opening, "x") == pytest.approx(knob.x_mm + x0)
	assert number(opening, "y") == pytest.approx(knob.y_mm + y0)
	assert x0 < 0 < x1
	assert y0 < 0 < y1


def test_knob_opening_contains_all_encoder_pads() -> None:
	x0, y0, x1, y1 = encoder_opening_local()
	pads = encoder_pad_extents_from_shaft()
	assert len(pads) == 7
	for px0, py0, px1, py1 in pads:
		assert x0 <= px0
		assert y0 <= py0
		assert px1 <= x1
		assert py1 <= y1


@pytest.mark.parametrize("side", SIDES)
def test_committed_plates_follow_board_outline(board: Board, side: Side) -> None:
	outline = board_outline(board, side)
	for kind in ("plate", "bottom"):
		(path,) = parse(BOARD_DIR / "plate" / f"{side}-{kind}.svg").findall(
			f".//{SVG}path"
		)
		numbers = [
			float(n) for n in attribute(path, "d").strip("MZ ").replace("L", "").split()
		]
		points = list(zip(numbers[::2], numbers[1::2], strict=True))
		assert len(points) == len(outline)
		for found, wanted in zip(points, outline, strict=True):
			assert found == pytest.approx(wanted, abs=1e-4)


@pytest.mark.parametrize(("side", "angle"), [("left", 29), ("right", -29)])
def test_thumb3_cutout_rotation(
	built: dict[Side, Half], side: Side, angle: float, tmp_path: Path
) -> None:
	positions, outline, holes = build(built, side)
	path = tmp_path / "plate.svg"
	write_plate_svg(path, positions, outline, holes, "plate")
	(thumb,) = [k for k in positions if k.id == "thumb3"]
	(rect,) = [
		r
		for r in parse(path).findall(f".//{SVG}rect")
		if number(r, "x") == pytest.approx(thumb.x_mm - 7, abs=1e-3)
		and number(r, "y") == pytest.approx(thumb.y_mm - 7, abs=1e-3)
	]
	name, args = attribute(rect, "transform").rstrip(")").split("(")
	rotation, cx, cy = map(float, args.split())
	assert name == "rotate"
	assert rotation == pytest.approx(angle)
	assert (cx, cy) == pytest.approx((thumb.x_mm, thumb.y_mm), abs=1e-3)


@pytest.mark.parametrize("side", SIDES)
def test_plate_viewbox_in_mm(
	built: dict[Side, Half], side: Side, tmp_path: Path
) -> None:
	positions, outline, holes = build(built, side)
	path = tmp_path / "plate.svg"
	write_plate_svg(path, positions, outline, holes, "plate")
	root = parse(path)
	min_x, _, width, height = map(float, attribute(root, "viewBox").split())
	assert attribute(root, "width") == f"{width}mm"
	assert attribute(root, "height") == f"{height}mm"
	assert min_x == pytest.approx(min(x for x, _ in outline))
	assert width == pytest.approx(
		max(x for x, _ in outline) - min(x for x, _ in outline)
	)


@pytest.mark.parametrize("side", SIDES)
def test_plate_holes_are_2_2mm(
	built: dict[Side, Half], side: Side, tmp_path: Path
) -> None:
	positions, outline, holes = build(built, side)
	path = tmp_path / "plate.svg"
	write_plate_svg(path, positions, outline, holes, "plate")
	circles = parse(path).findall(f".//{SVG}circle")
	assert len(circles) == len(holes)
	for circle in circles:
		assert number(circle, "r") == pytest.approx(1.1)


@pytest.mark.parametrize("side", SIDES)
def test_bottom_has_holes_only(
	built: dict[Side, Half], side: Side, tmp_path: Path
) -> None:
	positions, outline, holes = build(built, side)
	path = tmp_path / "bottom.svg"
	write_plate_svg(path, positions, outline, holes, "bottom")
	root = parse(path)
	assert root.findall(f".//{SVG}rect") == []
	assert len(root.findall(f".//{SVG}circle")) == len(holes)


def test_extra_holes_appear_on_bottom(built: dict[Side, Half], tmp_path: Path) -> None:
	positions, outline, holes = build(built, "left")
	path = tmp_path / "bottom.svg"
	write_plate_svg(
		path, positions, outline, holes, "bottom", extra_holes=[(1.5, 2.5, 3.0)]
	)
	circles = parse(path).findall(f".//{SVG}circle")
	assert len(circles) == len(holes) + 1
	extra = [c for c in circles if number(c, "r") == pytest.approx(1.5)]
	assert len(extra) == 1
	assert number(extra[0], "cx") == pytest.approx(1.5)
	assert number(extra[0], "cy") == pytest.approx(2.5)


def test_standoff_heights() -> None:
	parts = load_parts(BOARD_DIR)
	assert pytest.approx(1.30) == STANDOFF_HEIGHT_MM
	assert pytest.approx(2.50) == plate.STEM_TUBE_PROTRUSION_MM
	tallest = max(
		plate.STEM_TUBE_PROTRUSION_MM,
		plate.PEG_PROTRUSION_MM,
		parts["sensor"]["heightMm"],
		parts["usbc"]["heightMm"],
		parts["button"]["heightMm"],
	)
	assert (
		pytest.approx(tallest + plate.STANDOFF_MARGIN_MM) == BOTTOM_STANDOFF_HEIGHT_MM
	)
	assert BOTTOM_STANDOFF_HEIGHT_MM >= 2.50 + 0.5


def test_generate_writes_four_svgs_deterministically(tmp_path: Path) -> None:
	plate.generate(BOARD_DIR, tmp_path)
	names = sorted(p.name for p in tmp_path.iterdir())
	assert names == [
		"left-bottom.svg",
		"left-plate.svg",
		"right-bottom.svg",
		"right-plate.svg",
	]
	first = {p.name: p.read_bytes() for p in tmp_path.iterdir()}
	plate.generate(BOARD_DIR, tmp_path)
	assert {p.name: p.read_bytes() for p in tmp_path.iterdir()} == first


def test_committed_svgs_match_generator(tmp_path: Path) -> None:
	plate.generate(BOARD_DIR, tmp_path)
	for generated in tmp_path.iterdir():
		committed = BOARD_DIR / "plate" / generated.name
		assert committed.read_bytes() == generated.read_bytes()


@pytest.mark.parametrize("side", SIDES)
def test_committed_bottom_has_button_access_holes(side: Side) -> None:
	circles = parse(BOARD_DIR / "plate" / f"{side}-bottom.svg").findall(
		f".//{SVG}circle"
	)
	found = sorted(
		(number(c, "cx"), number(c, "cy"), 2 * number(c, "r"))
		for c in circles
		if number(c, "r") != pytest.approx(HOLE_DIAMETER_MM / 2)
	)
	expected = button_holes(BOARD_DIR, side)
	assert len(expected) == 2
	assert found == pytest.approx(sorted(expected), abs=1e-4)


@pytest.mark.parametrize("side", SIDES)
def test_committed_plate_holes_follow_placement(side: Side) -> None:
	for kind in ("plate", "bottom"):
		circles = parse(BOARD_DIR / "plate" / f"{side}-{kind}.svg").findall(
			f".//{SVG}circle"
		)
		found = sorted(
			(number(c, "cx"), number(c, "cy"))
			for c in circles
			if number(c, "r") == pytest.approx(HOLE_DIAMETER_MM / 2)
		)
		assert found == pytest.approx(sorted(board_holes(BOARD_DIR)[side]), abs=1e-4)
