Alexdelia/keyboard/tool/test/test_drc.py

import json
import subprocess
from pathlib import Path

import pytest
from kb.layout import Side

BOARD_DIR = Path(__file__).parents[2] / "keyboard" / "icarus"
SIDES: tuple[Side, ...] = ("left", "right")


@pytest.fixture(scope="module", params=SIDES)
def report(
	request: pytest.FixtureRequest, tmp_path_factory: pytest.TempPathFactory
) -> dict:
	side = request.param
	target = tmp_path_factory.mktemp("drc") / f"{side}.json"
	result = subprocess.run(
		[
			"kicad-cli",
			"pcb",
			"drc",
			"--schematic-parity",
			"--severity-all",
			"--format",
			"json",
			"-o",
			str(target),
			str(BOARD_DIR / "pcb" / side / f"{side}.kicad_pcb"),
		],
		capture_output=True,
		text=True,
		check=False,
	)
	assert result.returncode == 0, result.stderr
	return json.loads(target.read_text())


def test_schematic_parity(report: dict) -> None:
	assert report["schematic_parity"] == []


@pytest.mark.xfail(strict=True, reason="placement redone in Task 8a")
def test_no_violations_besides_unrouted(report: dict) -> None:
	assert [
		(v["type"], [item["description"] for item in v["items"]])
		for v in report["violations"]
	] == []


def test_every_severity_checked(report: dict) -> None:
	assert set(report["included_severities"]) >= {"error", "warning"}
