Alexdelia/keyboard/(commit log)

2026-11-08 feat: curve finger layout
2026-11-08 feat: tilt board
2026-11-08 feat: name future board
2026-11-08 feat: layout geometry for pcb placement
2026-11-08 feat: gateron magnetic jade footprint
2026-11-08 feat: icarus schematic
    [core.kicad_sch, left.kicad_sch, right.kicad_sch]
2026-11-08 feat(icarus): plate
2026-11-08 feat: pcb generator
    [left.kicad_pcb, right.kicad_pcb]
2026-11-09 save: progress on pcb
    [core.kicad_sch, left.kicad_pcb, right.kicad_pcb]
2026-11-09 feat: progress on board layout and pcb
2026-11-09 feat: `drawing` & `schematic`
    [left.kicad_pcb, right.kicad_pcb, right.kicad_sch]
